datuarellano/wonderpole_ensemble/README.md

# Wonderpole Ensemble

The original Wonderpole is a homemade digital synthesizer in a unique pole form factor, and makes sound by responding to touch and orientation. It was envisioned by Datu Arellano (visual artist, musician, maker) and Malek Lopez (composer, music producer, electronic musician) in 2019 as part of an event organized by CREATE PH and Manila International Performing Arts Market.

**The Wonderpole Ensemble** is the open source, open hardware, workshop-friendly, and low cost, version of the original, and was designed in 2023. It is based on the Arduino Nano microcontroller board and the Mozzi sound synthesis library.

As an open source and educational project, the goal is to create a STEAM-based* learning platform that is open to people of a wide age range and a variety of skill sets. It encourages creativity, collaboration, and community.  

> *"STEAM Education is an approach to learning that uses Science, Technology, Engineering, the Arts and Mathematics as access points for guiding student inquiry, dialogue, and critical thinking." [More on STEAM](https://artsintegration.com/what-is-steam-education-in-k-12-schools/)

## Contents of this repository
This repository contains the source code of the Wonderpole Ensemble, the schematics, and the ~~source files of the PCB design~~ (to come in a future update!)

## Installation and Build Instructions
Please check [the wiki](https://github.com/datuarellano/wonderpole_ensemble/wiki/).

<!-- 
## The Wonderpole Ensemble 
### Features
### Donate
## Requirements
### Dependencies
## Bug Reports
## Links 
-->
## License
The Wonderpole Ensemble is published under the [MIT License](https://github.com/datuarellano/wonderpole_ensemble/blob/master/LICENSE).
## Credits
Concept: Datu Arellano and Malek Lopez <br>
Design, build, programming, workshops: Datu Arellano <br>
Manila, Philippines

## Acknowledgements

Heartfelt gratitude to the following people and institutions who have contributed, in one way or another, to the evolution of the Wonderpole Project:

(In no particular order) Malek Lopez, Dayang Yraola, Erwin Romulo, Create PH, Paschal Berry, Art Gallery of New South Wales, Donna Cher dela Cruz, Diego Arellano, Damian Arellano, Delfin Arellano.
