datuarellano/wonderpole_ensemble/Resources/Schematic/Schematic - Wonderpole Ensemble.pdf

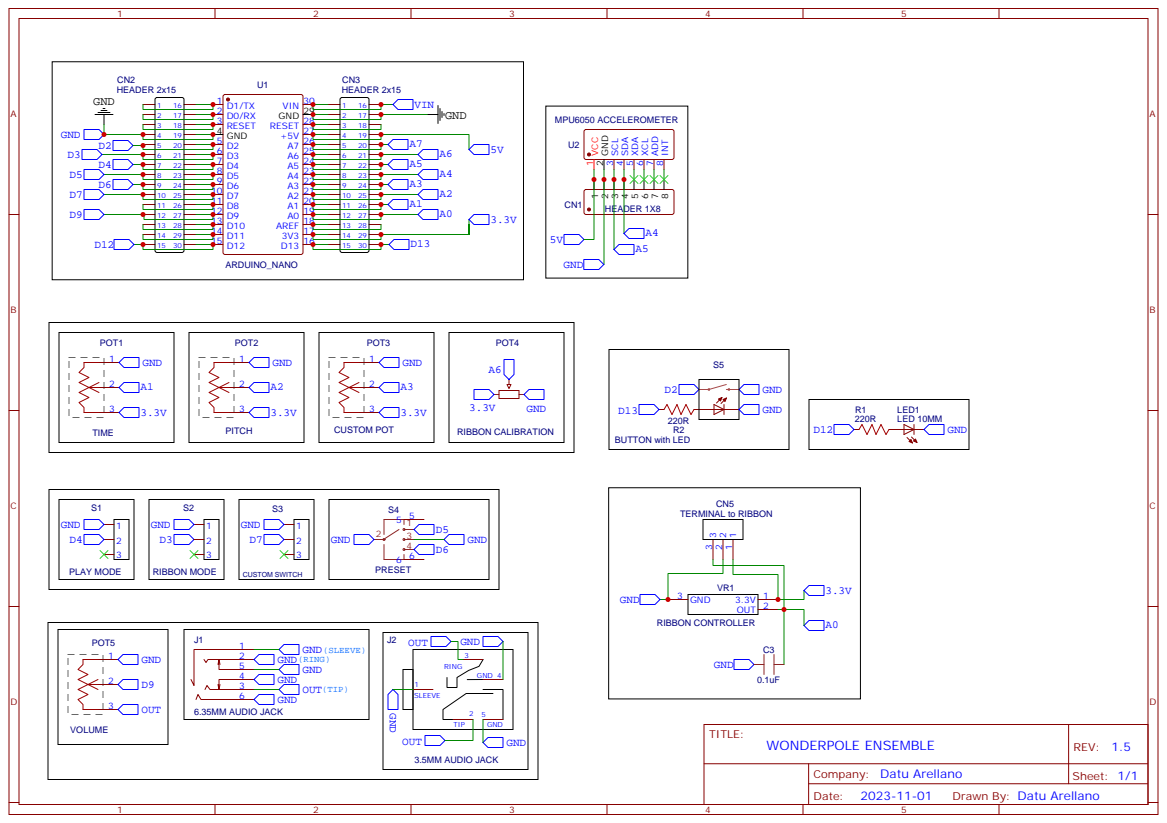
[picture p1: page 1]

Drawn By: Datu Arellano
