datuarellano/wonderpole_ensemble/Resources/PCB/PCB_Wonderpole Ensemble BnW BOTTOM.pdf

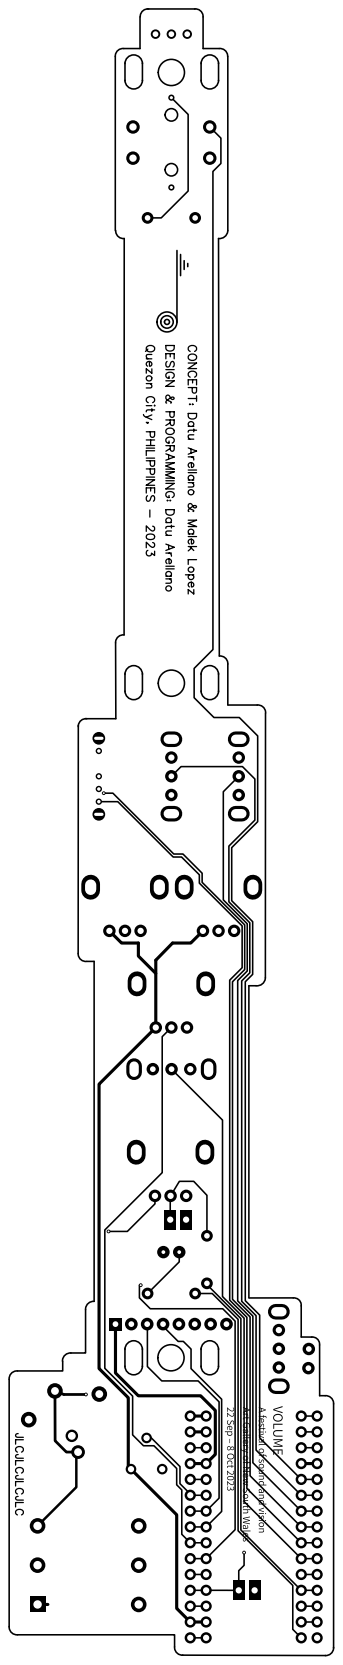
[picture p2: page 1]
