datuarellano/wonderpole_ensemble/Resources/PCB/PCB_Wonderpole Ensemble BnW TOP.pdf

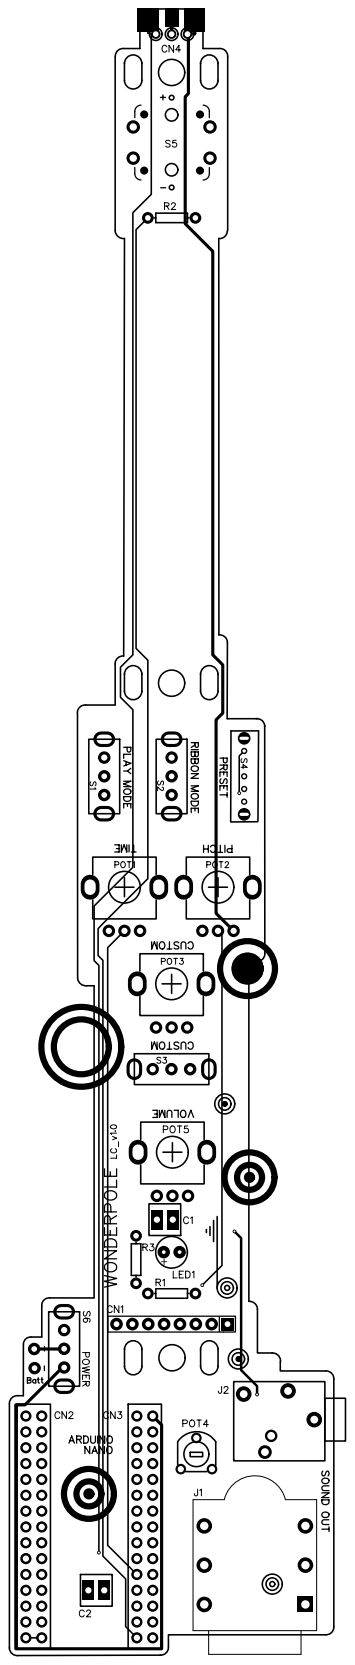
[picture p3: page 1]
