datuarellano/wonderpole_ensemble/Resources/PCB/PCB_Wonderpole Ensemble Color BOTTOM.pdf

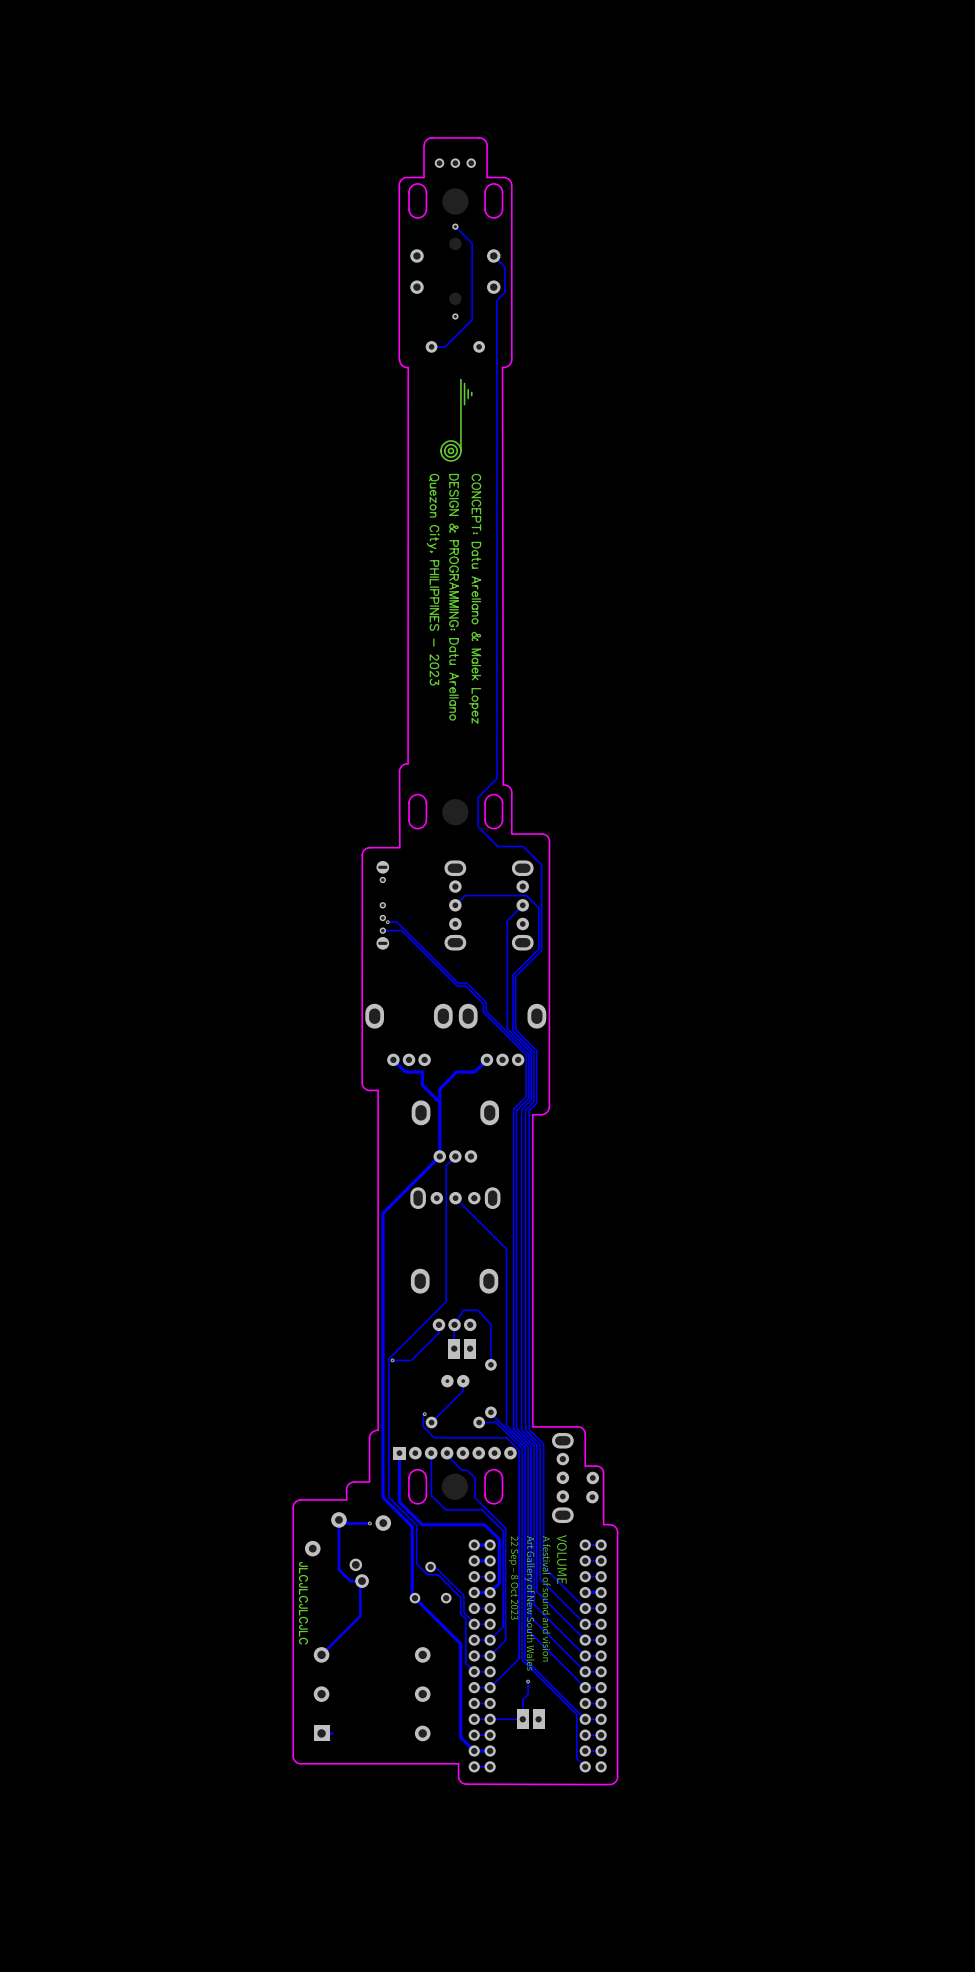
[picture p4: page 1]
