datuarellano/wonderpole_ensemble/Resources/PCB/PCB_Wonderpole Ensemble Color TOP.pdf

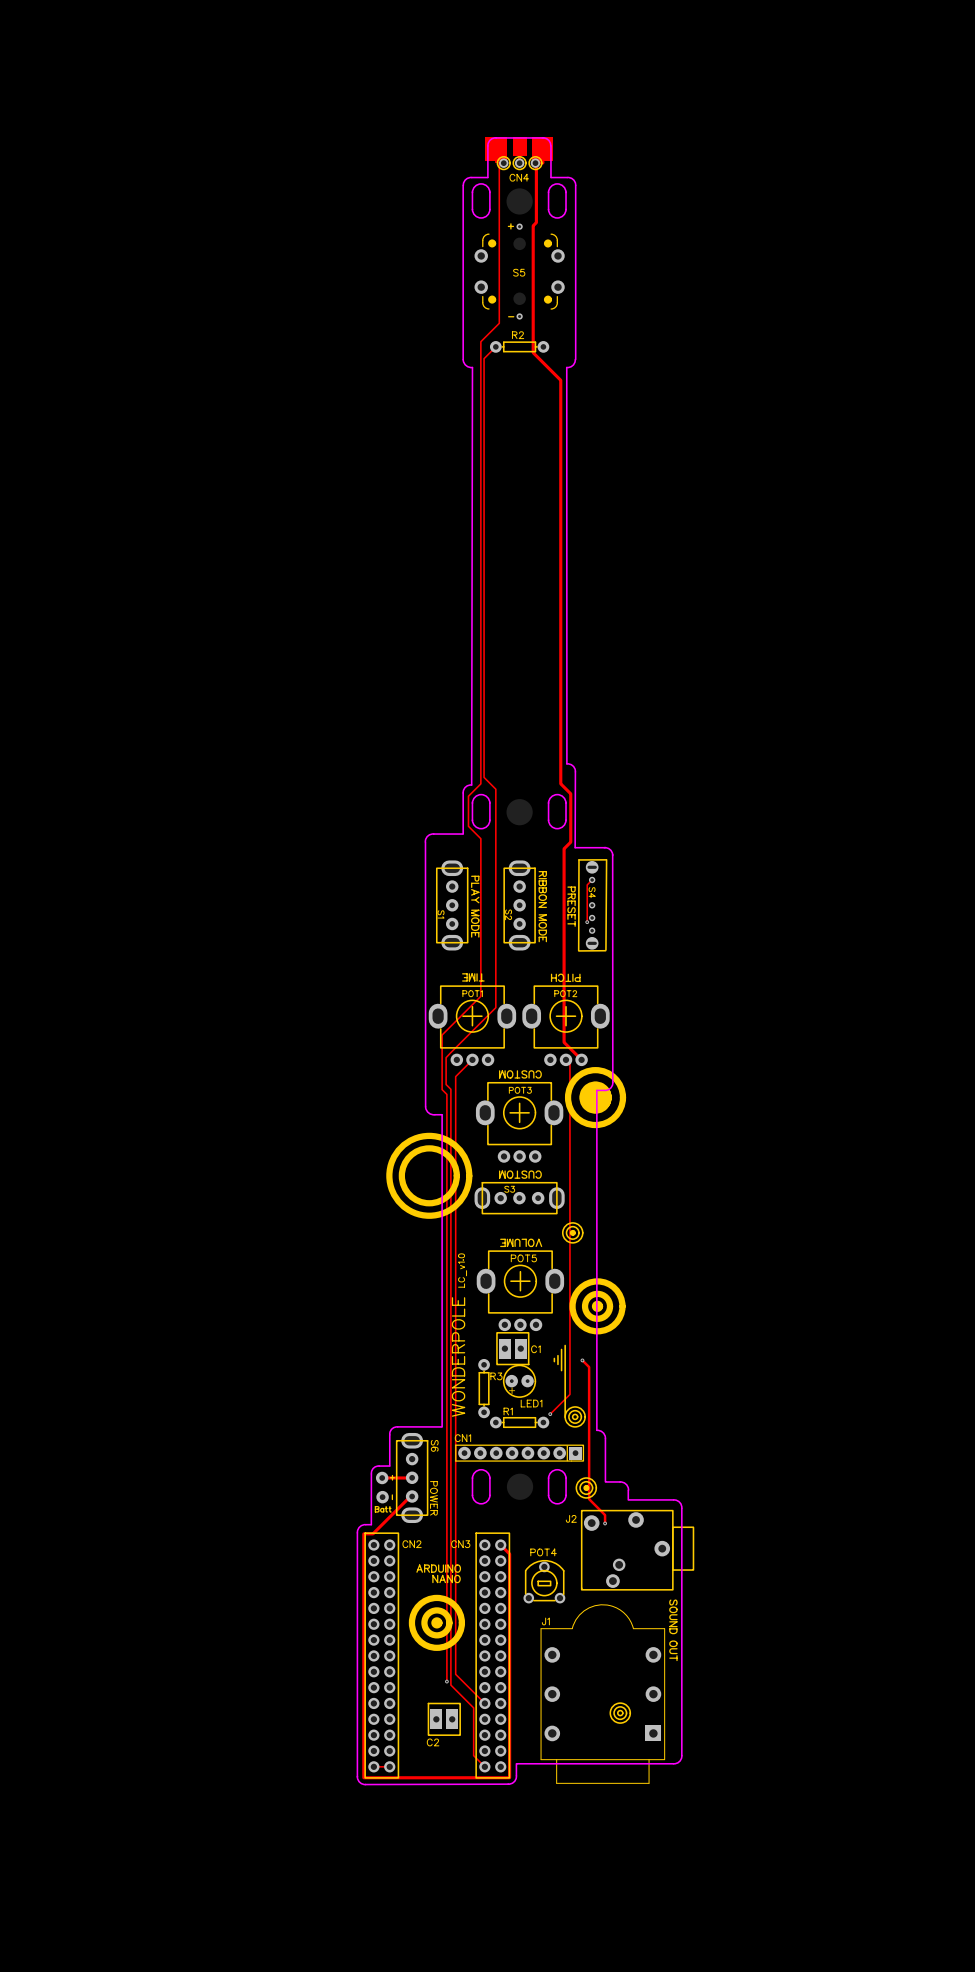
[picture p5: page 1]
