datuarellano/wonderpole_ensemble/(threads)

Thread 1 (2023-10-29):

No sound if Wonderpole is powered up and PRESET switch is set to third position

datuarellano, 2023-10-29:
When powering up the Wonderpole and the PRESET switch is set to the third position, no sound will be generated when you press the gate button (red tactile switch). The problem goes away if you select a different preset (switch position 1 or 2) and then switch back to the third.

I'm probably missing something here. Preset switch not updating and being read on boot? Something wrong with my logic? Need to do something in setup()?
