datuarellano/wonderpole_ensemble/(commit log)

2023-09-16 Initial commit of Wonderpole Ensemble code base
    - converted from the original PlatformIO code base
    - big improvements done on accelerometer code (now non-blocking and no compile errors in Arduino IDE)
    [accelerometer.h, accelerometer_advanced_setup.h, controls.h, ribbon.h, setup.h, wonderpole_ensemble.ino]
2023-09-21 add schematic
2023-09-21 add PCB reference images
2023-09-22 add missing accelerometer setup function
    [setup.h]
2023-10-22 rename potentiometer pin 1 variable name
2023-10-22 refactor ribbon calibration and segmentation
    - add descriptive comments as well
2023-10-22 add corrections as annotations
    TODO: Update the schematic
2023-10-23 fix ribbon segment values
    [ribbon.h]
2023-10-25 simplify accelerometer mode sound design
2023-10-25 simplify accelerometer mode volume mapping
2023-10-25 create variables for accelerometer mode tuning
2023-10-29 add config files for VSCode Arduino extension support
2023-11-01 Update Schematic - Wonderpole Ensemble.pdf
2023-12-18 refactor play mode switching
